imaginaryimpedance/RLC_meter/PCB/rlc_meter.kicad_pcb

## KiCad design PCB/rlc_meter.kicad_pcb (2023-05-07)

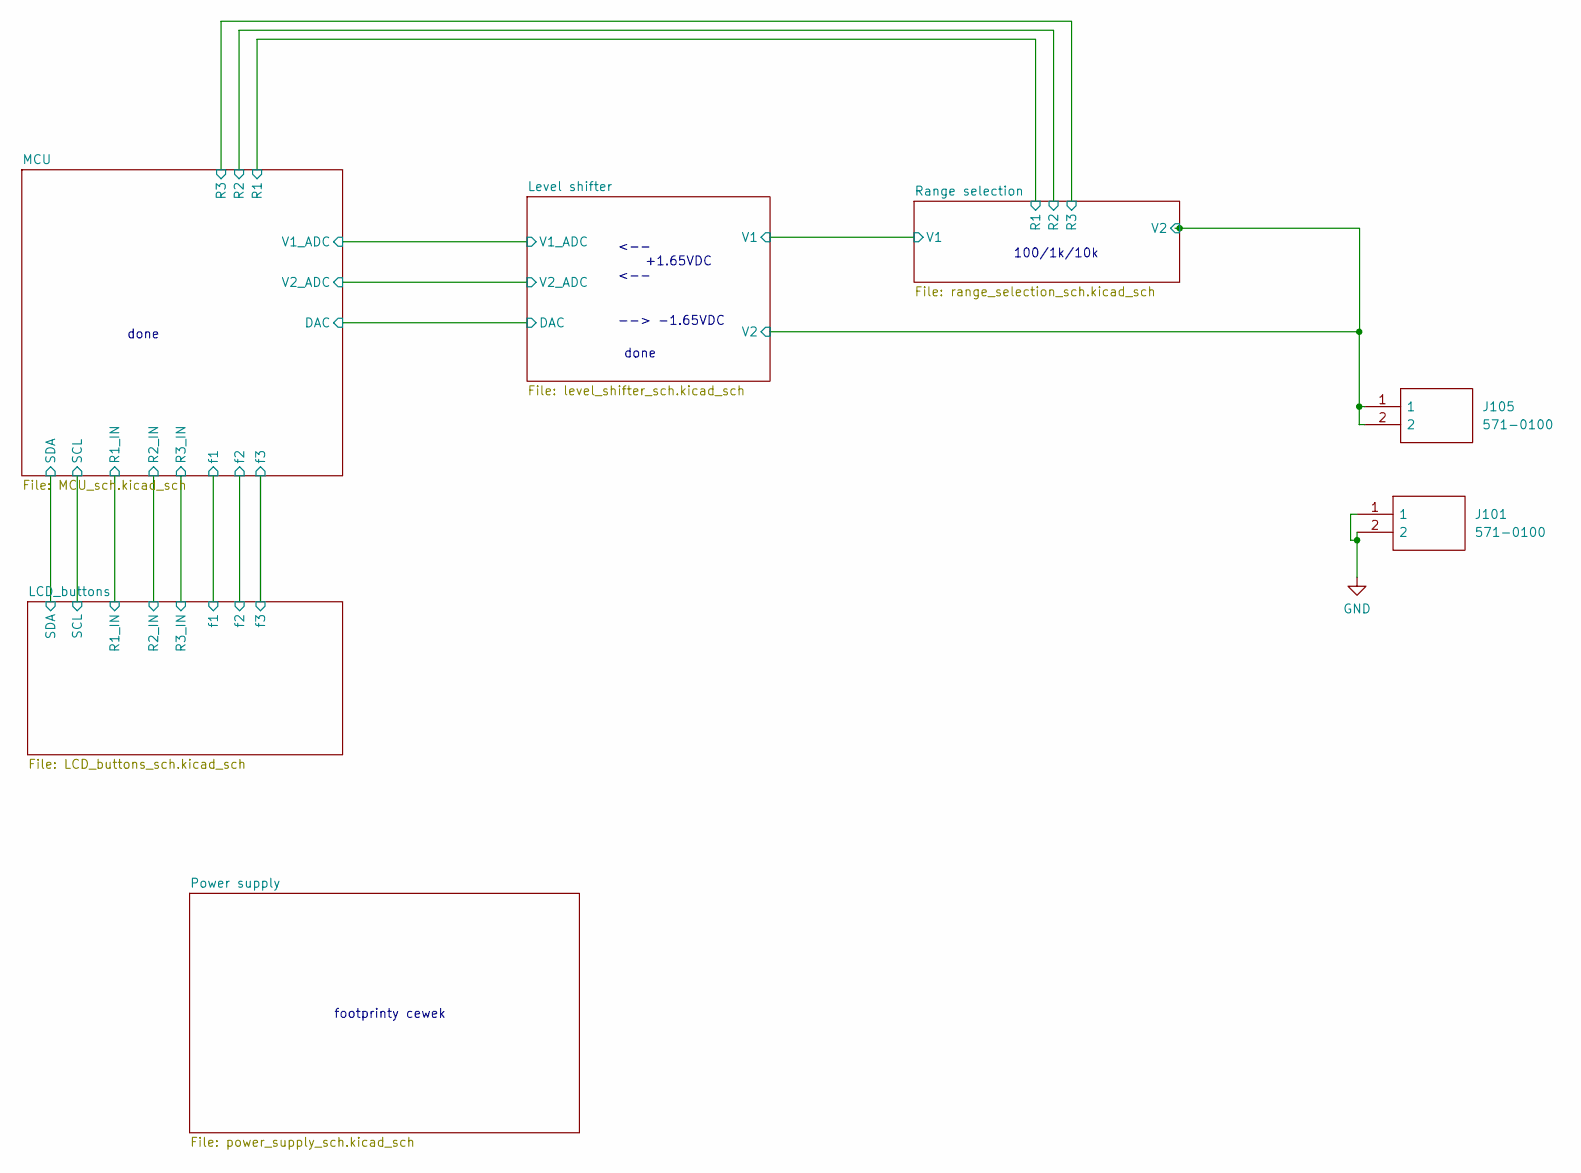
[picture p2: schematic rlc_meter.kicad_sch]

Parts:
J101, J105: 571-0100; 5710100; Manufacturer_Part_Number 571-0100; Mouser Part Number 164-6218

Connections:
/Level shifter/V2: J105.1, J105.2; also elsewhere on the board
GND: J101.1, J101.2; also elsewhere on the board

Notes on the sheet:
100/1k/10k
<-- +1.65VDC <--
footprinty cewek
done
--> -1.65VDC

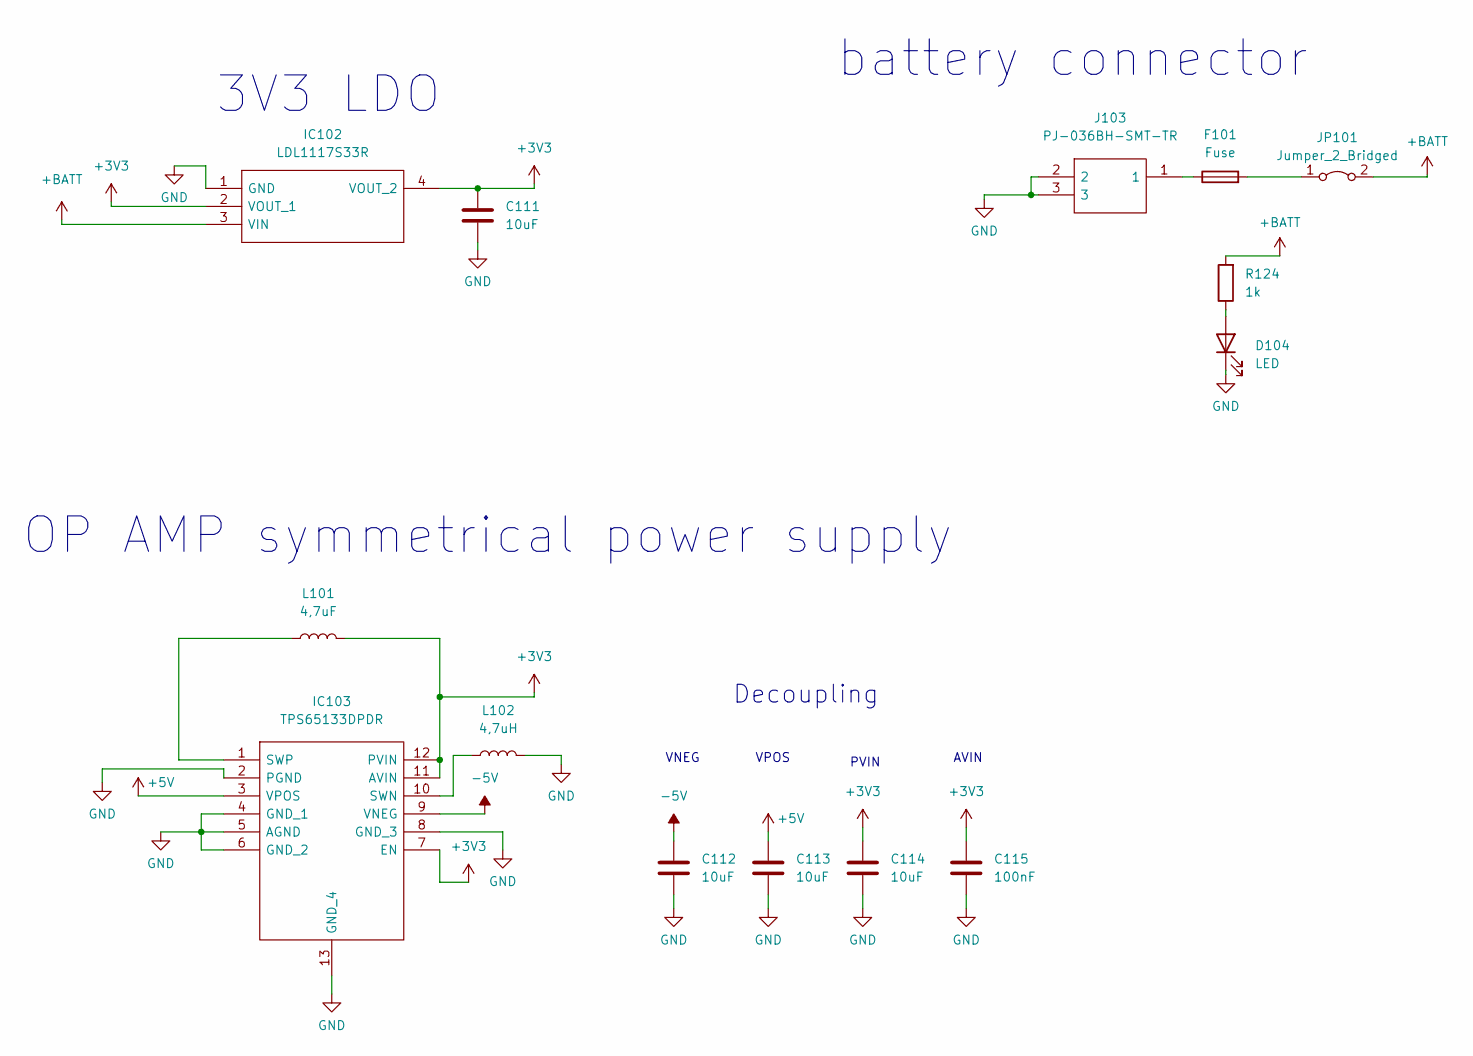
[picture p3: schematic power_supply_sch.kicad_sch]

Parts:
C111, C112, C113, C114: 10uF; C_1206_3216Metric
C115: 100nF; C_1206_3216Metric
D104: LED; LED_1206_3216Metric
F101: Fuse; Fuse_1206_3216Metric
IC102: LDL1117S33R; SOT230P700X180-4N; Manufacturer_Part_Number LDL1117S33R; Mouser Part Number 511-LDL1117S33R
IC103: TPS65133DPDR; SON45P300X300X80-13N-D; Manufacturer_Part_Number TPS65133DPDR; Mouser Part Number 595-TPS65133DPDR
J103: PJ-036BH-SMT-TR; PJ036BHSMTTR; Manufacturer_Part_Number PJ-036BH-SMT-TR; Mouser Part Number 490-PJ-036BH-SMT-TR
JP101: Jumper_2_Bridged; PinHeader_1x02_P2.54mm_Vertical_SMD_Pin1Right
L101: 4,7uF; 744031004
L102: 4,7uH; 744031004
R124: 1k; R_1206_3216Metric

Connections:
+3V3: C111.1, C114.1, C115.1, IC102.2 (VOUT_1), IC102.4 (VOUT_2), IC103.7 (EN), IC103.11 (AVIN), IC103.12 (PVIN), L101.2; also elsewhere on the board
+5V: C113.1, IC103.3 (VPOS); also elsewhere on the board
+BATT: IC102.3 (VIN), JP101.2 (B), R124.2
-5V: C112.1, IC103.9 (VNEG); also elsewhere on the board
GND: C111.2, C112.2, C113.2, C114.2, C115.2, D104.1 (K), IC102.1 (GND), IC103.2 (PGND), IC103.4 (GND_1), IC103.5 (AGND), IC103.6 (GND_2), IC103.8 (GND_3), IC103.13 (GND_4), J103.2, J103.3, L102.2; also elsewhere on the board
unnamed: D104.2 (A), R124.1
unnamed: F101.1, J103.1
unnamed: F101.2, JP101.1 (A)
unnamed: IC103.1 (SWP), L101.1
unnamed: IC103.10 (SWN), L102.1

Notes on the sheet:
battery connector
3V3 LDO
VPOS
PVIN
OP AMP symmetrical power supply
AVIN
Decoupling
VNEG

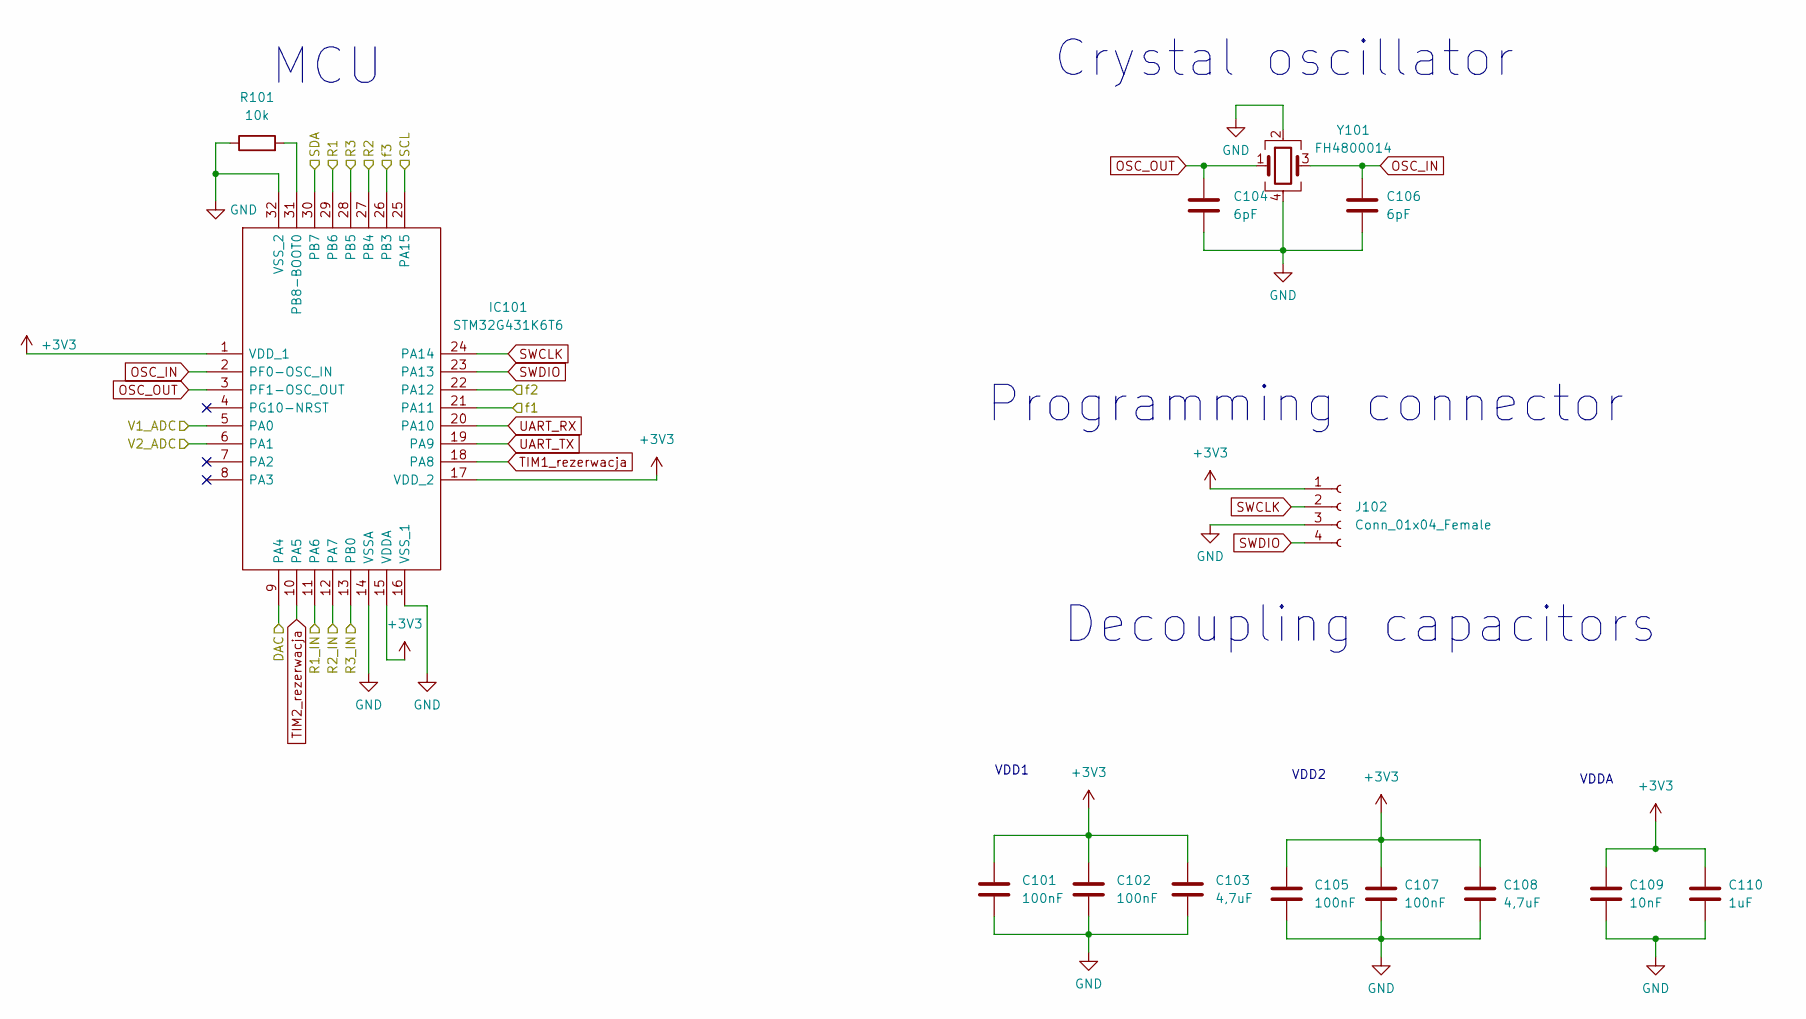
[picture p4: schematic MCU_sch.kicad_sch]

Parts:
C101, C102, C105, C107: 100nF; C_1206_3216Metric
C103, C108: 4,7uF; C_1206_3216Metric
C104, C106: 6pF; C_1206_3216Metric
C109: 10nF; C_1206_3216Metric
C110: 1uF; C_1206_3216Metric
IC101: STM32G431K6T6; QFP80P900X900X160-32N; Manufacturer_Part_Number STM32G431K6T6; Mouser Part Number 511-STM32G431K6T6
J102: Conn_01x04_Female; PinHeader_1x04_P2.54mm_Vertical_SMD_Pin1Left
R101: 10k; R_1206_3216Metric
Y101: FH4800014

Connections:
+3V3: C101.1, C102.1, C103.1, C105.1, C107.1, C108.1, C109.1, C110.1, IC101.1 (VDD_1), IC101.15 (VDDA), IC101.17 (VDD_2), J102.1; also elsewhere on the board
/LCD_buttons/R1_IN: IC101.11 (PA6); also elsewhere on the board
/LCD_buttons/R2_IN: IC101.12 (PA7); also elsewhere on the board
/LCD_buttons/R3_IN: IC101.13 (PB0); also elsewhere on the board
/LCD_buttons/SCL: IC101.25 (PA15); also elsewhere on the board
/LCD_buttons/SDA: IC101.30 (PB7); also elsewhere on the board
/LCD_buttons/f1: IC101.21 (PA11); also elsewhere on the board
/LCD_buttons/f2: IC101.22 (PA12); also elsewhere on the board
/LCD_buttons/f3: IC101.26 (PB3); also elsewhere on the board
/Level shifter/DAC: IC101.9 (PA4); also elsewhere on the board
/Level shifter/V1_ADC: IC101.5 (PA0); also elsewhere on the board
/Level shifter/V2_ADC: IC101.6 (PA1); also elsewhere on the board
/MCU/R1: IC101.29 (PB6); also elsewhere on the board
/MCU/R2: IC101.27 (PB4); also elsewhere on the board
/MCU/R3: IC101.28 (PB5); also elsewhere on the board
GND: C101.2, C102.2, C103.2, C104.2, C105.2, C106.2, C107.2, C108.2, C109.2, C110.2, IC101.14 (VSSA), IC101.16 (VSS_1), IC101.32 (VSS_2), J102.3, R101.1, Y101.2, Y101.4; also elsewhere on the board
unnamed: IC101.31 (PB8-BOOT0), R101.2
OSC_IN: C106.1, IC101.2 (PF0-OSC_IN), Y101.3
OSC_OUT: C104.1, IC101.3 (PF1-OSC_OUT), Y101.1
SWCLK: IC101.24 (PA14), J102.2
SWDIO: IC101.23 (PA13), J102.4
TIM1_rezerwacja: IC101.18 (PA8)
TIM2_rezerwacja: IC101.10 (PA5)
UART_RX: IC101.20 (PA10)
UART_TX: IC101.19 (PA9)

Notes on the sheet:
VDD2
MCU
VDD1
VDDA
Decoupling capacitors
Crystal oscillator
Programming connector

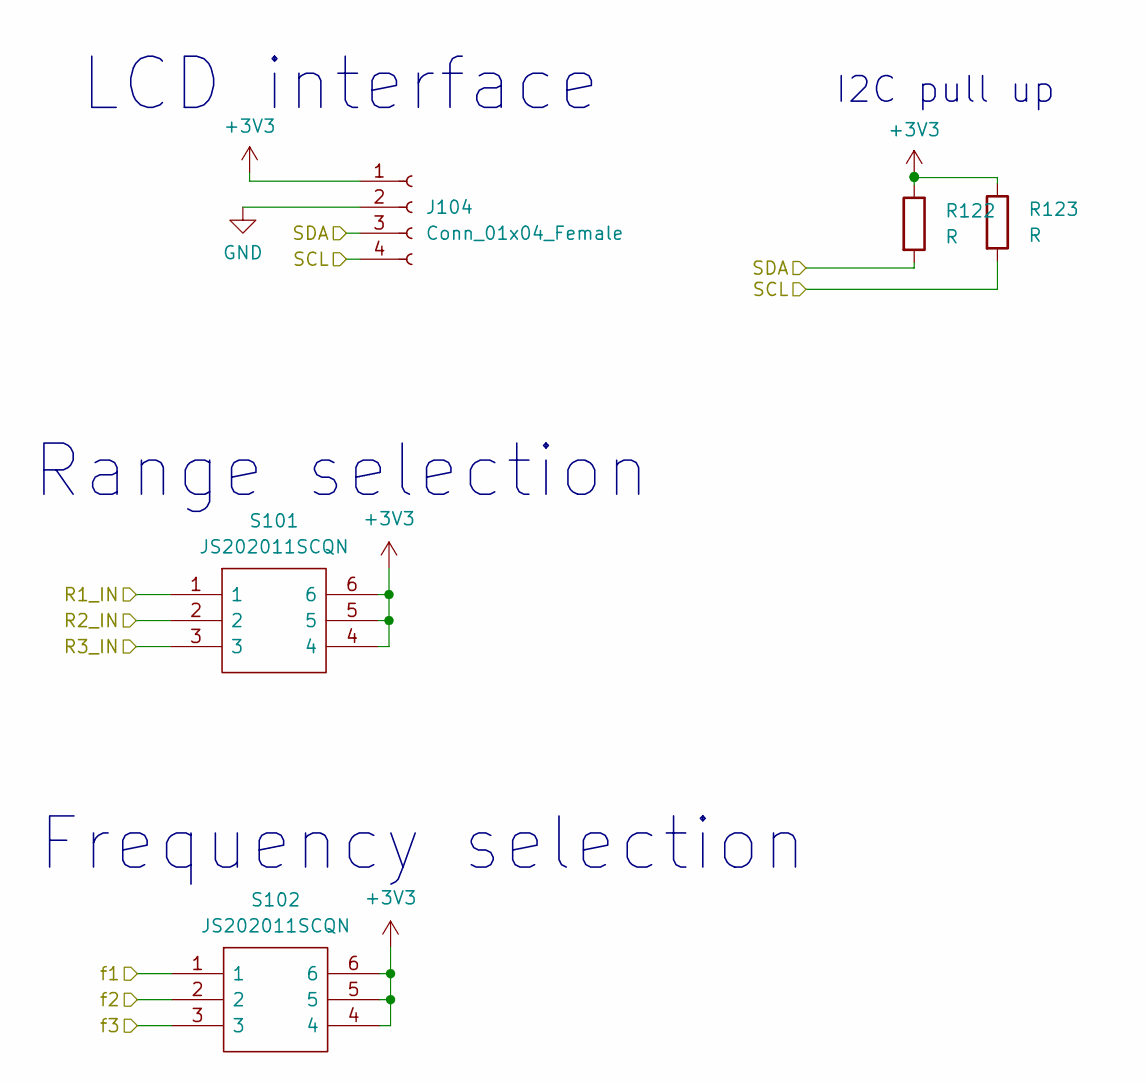
[picture p5: schematic LCD_buttons_sch.kicad_sch]

Parts:
J104: Conn_01x04_Female; PinHeader_1x04_P2.54mm_Vertical_SMD_Pin1Left
R122, R123: R; R_1206_3216Metric
S101, S102: JS202011SCQN; Manufacturer_Part_Number JS202011SCQN; Mouser Part Number 611-JS202011SCQN

Connections:
+3V3: J104.1, R122.1, R123.1, S101.4, S101.5, S101.6, S102.4, S102.5, S102.6; also elsewhere on the board
/LCD_buttons/R1_IN: S101.1; also elsewhere on the board
/LCD_buttons/R2_IN: S101.2; also elsewhere on the board
/LCD_buttons/R3_IN: S101.3; also elsewhere on the board
/LCD_buttons/SCL: J104.4, R123.2; also elsewhere on the board
/LCD_buttons/SDA: J104.3, R122.2; also elsewhere on the board
/LCD_buttons/f1: S102.1; also elsewhere on the board
/LCD_buttons/f2: S102.2; also elsewhere on the board
/LCD_buttons/f3: S102.3; also elsewhere on the board
GND: J104.2; also elsewhere on the board

Notes on the sheet:
I2C pull up
LCD interface
Frequency selection
Range selection

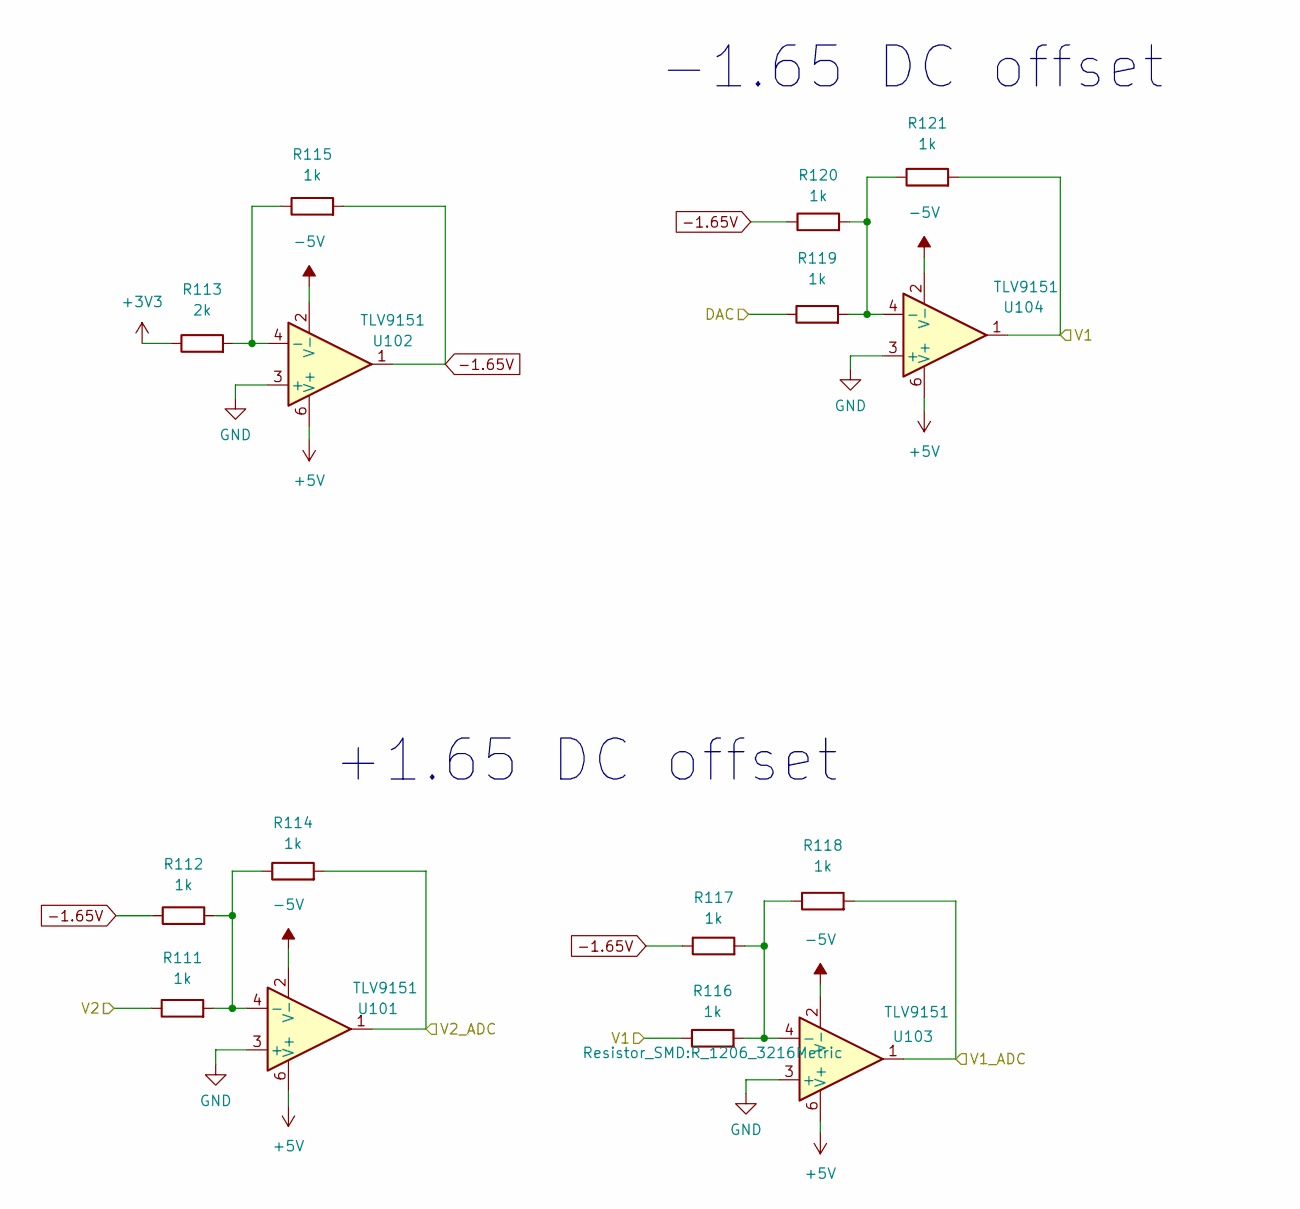
[picture p6: schematic level_shifter_sch.kicad_sch]

Parts:
R111, R112, R114, R115, R116, R117, R118, R119, R120, R121: 1k; R_1206_3216Metric
R113: 2k; R_1206_3216Metric
U101, U102, U103, U104: TLV9151; SOT95P280X145-6N

Connections:
+3V3: R113.1; also elsewhere on the board
+5V: U101.6 (V+), U102.6 (V+), U103.6 (V+), U104.6 (V+); also elsewhere on the board
-1.65V: R112.1, R115.2, R117.1, R120.1, U102.1
-5V: U101.2 (V-), U102.2 (V-), U103.2 (V-), U104.2 (V-); also elsewhere on the board
/Level shifter/DAC: R119.1; also elsewhere on the board
/Level shifter/V1: R116.1, R121.2, U104.1; also elsewhere on the board
/Level shifter/V1_ADC: R118.2, U103.1; also elsewhere on the board
/Level shifter/V2: R111.1; also elsewhere on the board
/Level shifter/V2_ADC: R114.2, U101.1; also elsewhere on the board
GND: U101.3 (+), U102.3 (+), U103.3 (+), U104.3 (+); also elsewhere on the board
unnamed: R111.2, R112.2, R114.1, U101.4 (-)
unnamed: R113.2, R115.1, U102.4 (-)
unnamed: R116.2, R117.2, R118.1, U103.4 (-)
unnamed: R119.2, R120.2, R121.1, U104.4 (-)

Notes on the sheet:
-1.65 DC offset
+1.65 DC offset

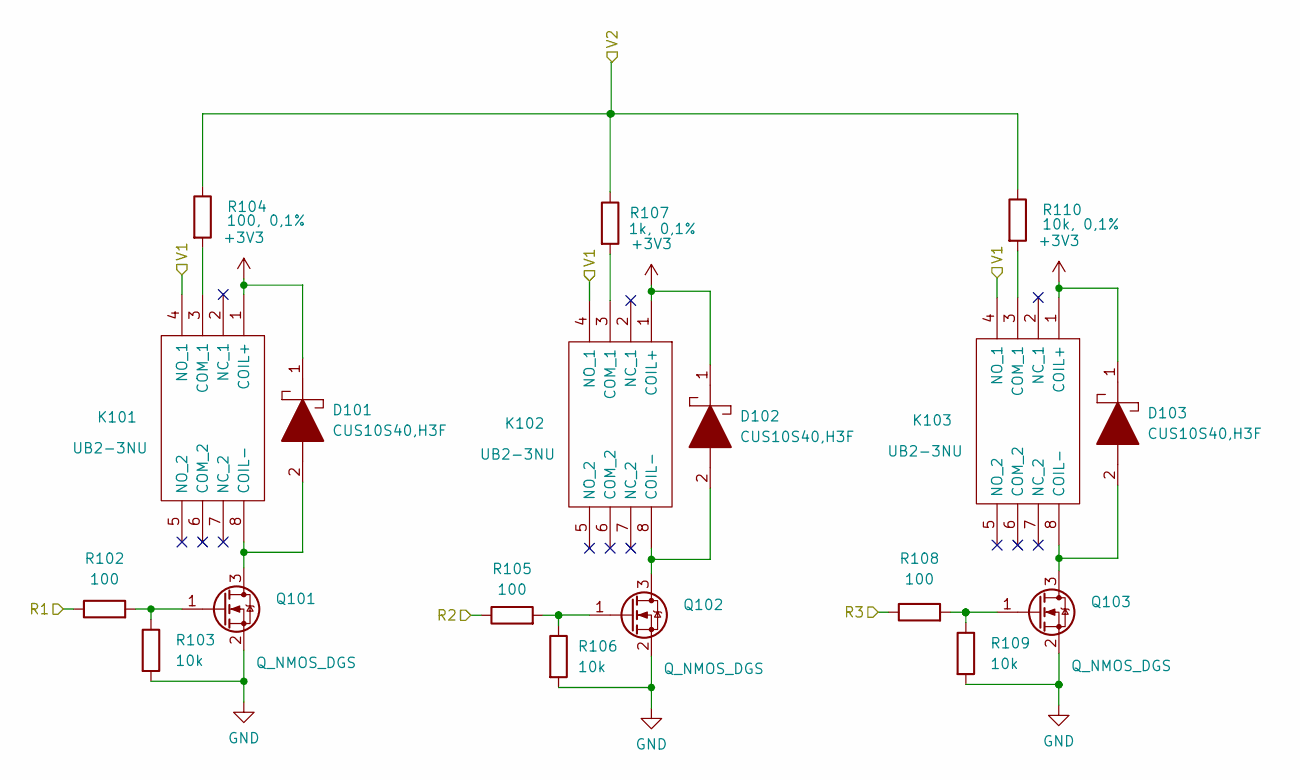
[picture p7: schematic range_selection_sch.kicad_sch]

Parts:
D101, D102, D103: CUS10S40,H3F; CUS10S40H3F; Manufacturer_Part_Number CUS10S40,H3F; Mouser Part Number 757-CUS10S40H3F
K101, K102, K103: UB2-3NU; UB23NU; Manufacturer_Part_Number UB2-3NU; Mouser Part Number 551-UB2-3NU
Q101, Q102, Q103: Q_NMOS_DGS; SOT96P237X111-3N
R102, R105, R108: 100; R_1206_3216Metric
R103, R106, R109: 10k; R_1206_3216Metric
R104: 100, 0,1%; R_1206_3216Metric
R107: 1k, 0,1%; R_1206_3216Metric
R110: 10k, 0,1%; R_1206_3216Metric

Connections:
+3V3: D101.1, D102.1, D103.1, K101.1 (COIL+), K102.1 (COIL+), K103.1 (COIL+); also elsewhere on the board
/Level shifter/V1: K101.4 (NO_1), K102.4 (NO_1), K103.4 (NO_1); also elsewhere on the board
/Level shifter/V2: R104.1, R107.1, R110.1; also elsewhere on the board
/MCU/R1: R102.1; also elsewhere on the board
/MCU/R2: R105.1; also elsewhere on the board
/MCU/R3: R108.1; also elsewhere on the board
GND: Q101.2 (S), Q102.2 (S), R103.2, R106.2, R109.2; also elsewhere on the board
unnamed: D101.2, K101.8 (COIL-), Q101.3 (D)
unnamed: D102.2, K102.8 (COIL-), Q102.3 (D)
unnamed: D103.2, K103.8 (COIL-), Q103.3 (D)
unnamed: K101.3 (COM_1), R104.2
unnamed: K102.3 (COM_1), R107.2
unnamed: K103.3 (COM_1), R110.2
unnamed: Q101.1 (G), R102.2, R103.1
unnamed: Q102.1 (G), R105.2, R106.1
unnamed: Q103.1 (G), R108.2, R109.1

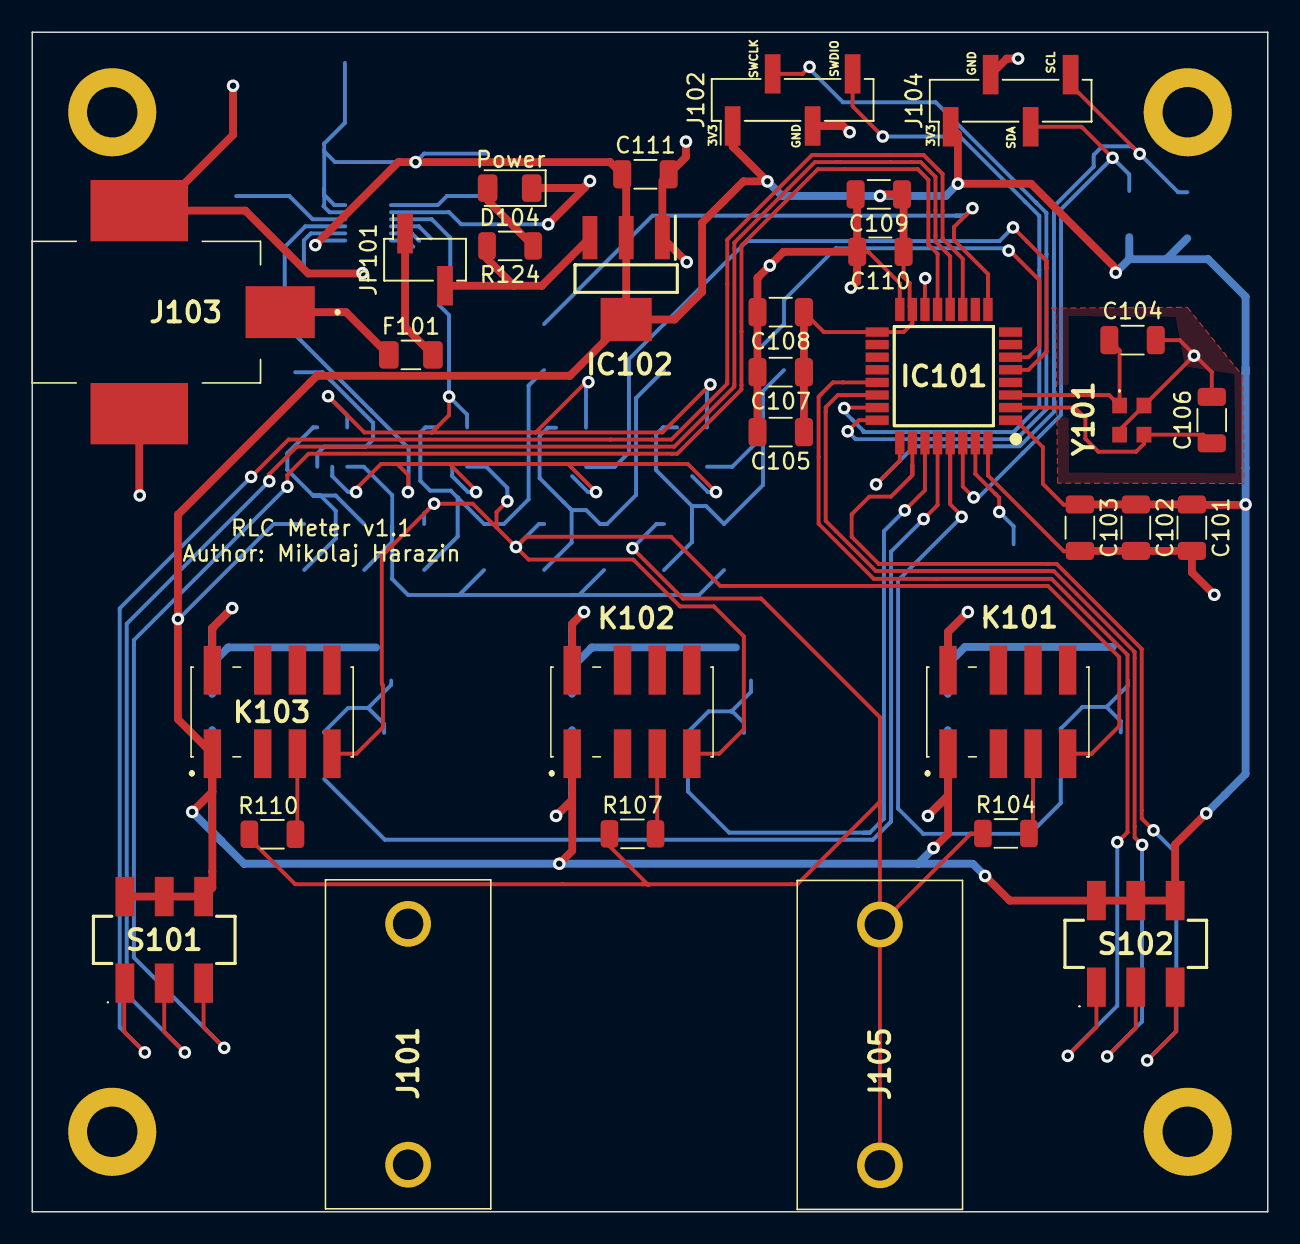
[picture p8: board rlc_meter.kicad_pcb from above]

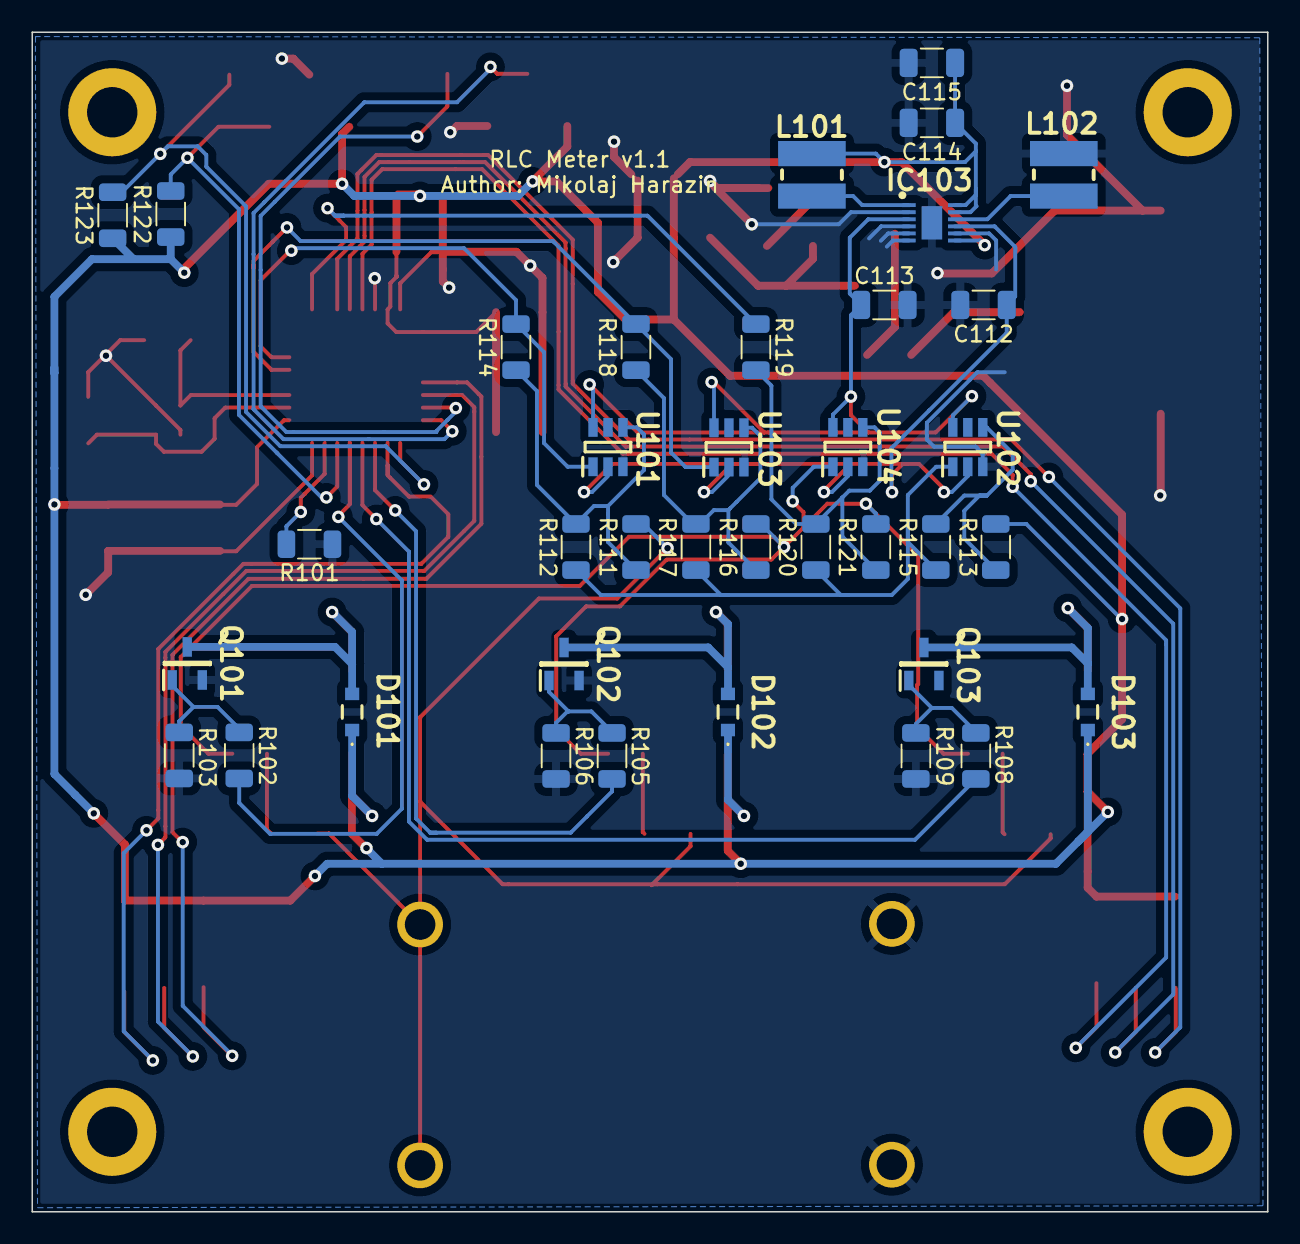
[picture p9: board rlc_meter.kicad_pcb from below]

Board: 2 copper layers, 78.5 x 74.9 mm, 68 parts (37 on the bottom side), 45 nets.
