imaginaryimpedance/RLC_meter/Code/RLC_G4/Core/Src/main.c

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
/* Includes ------------------------------------------------------------------*/
#include "main.h"

/* USER CODE BEGIN Includes */
#include "fonts.h"  //oled
#include "ssd1306.h" //oled
#include "test.h"  //oled
#include "math.h"

/* USER CODE END Includes */

/* USER CODE BEGIN PD */

//DAC sine wave sample points

#define NS  128

uint32_t Wave_LUT[NS] = {
    2048, 2149, 2250, 2350, 2450, 2549, 2646, 2742, 2837, 2929, 3020, 3108, 3193, 3275, 3355,
    3431, 3504, 3574, 3639, 3701, 3759, 3812, 3861, 3906, 3946, 3982, 4013, 4039, 4060, 4076,
    4087, 4094, 4095, 4091, 4082, 4069, 4050, 4026, 3998, 3965, 3927, 3884, 3837, 3786, 3730,
    3671, 3607, 3539, 3468, 3394, 3316, 3235, 3151, 3064, 2975, 2883, 2790, 2695, 2598, 2500,
    2400, 2300, 2199, 2098, 1997, 1896, 1795, 1695, 1595, 1497, 1400, 1305, 1212, 1120, 1031,
    944, 860, 779, 701, 627, 556, 488, 424, 365, 309, 258, 211, 168, 130, 97,
    69, 45, 26, 13, 4, 0, 1, 8, 19, 35, 56, 82, 113, 149, 189,
    234, 283, 336, 394, 456, 521, 591, 664, 740, 820, 902, 987, 1075, 1166, 1258,
    1353, 1449, 1546, 1645, 1745, 1845, 1946, 2047
};

/* USER CODE END PD */

ADC_HandleTypeDef hadc1;
ADC_HandleTypeDef hadc2;

DAC_HandleTypeDef hdac1;
DMA_HandleTypeDef hdma_dac1_ch2;

I2C_HandleTypeDef hi2c1;

TIM_HandleTypeDef htim2;
TIM_HandleTypeDef htim3;
TIM_HandleTypeDef htim4;

/* USER CODE BEGIN PV */
int fSine = 50; //DAC sine frequency
int Rn = 100;  //shunt resistance

int R = 27;   //measured resistance
int X = 0;   //measured reactance

int V1 = 0; //measured voltage1
int V2 = 0; //measured voltage2

uint32_t V1_avg=0;  //DC offset

uint32_t V1_sum=0;
uint32_t V2_sum=0;

float V1_rms=0;			//calculated voltage1 rms
float V2_rms =0;  		//calculated voltage2 rms

uint32_t samples = 0; //sample count

int flag = 0; //flag = 1 for TIM3 interrupt

uint32_t V1_t,V2_t;

/* USER CODE END PV */

void SystemClock_Config(void);
static void MX_GPIO_Init(void);
static void MX_DMA_Init(void);
static void MX_I2C1_Init(void);
static void MX_DAC1_Init(void);
static void MX_TIM2_Init(void);
static void MX_ADC1_Init(void);
static void MX_TIM3_Init(void);
static void MX_ADC2_Init(void);
static void MX_TIM4_Init(void);
/**
  * @brief  The application entry point.
  * @retval int
  */
int main(void)
{
  /* MCU Configuration--------------------------------------------------------*/

  /* Reset of all peripherals, Initializes the Flash interface and the Systick. */
  HAL_Init();

  /* Configure the system clock */
  SystemClock_Config();

  /* Initialize all configured peripherals */
  MX_GPIO_Init();
  MX_DMA_Init();
  MX_I2C1_Init();
  MX_DAC1_Init();
  MX_TIM2_Init();
  MX_ADC1_Init();
  MX_TIM3_Init();
  MX_ADC2_Init();
  MX_TIM4_Init();
  /* USER CODE BEGIN 2 */

  //starting timers
  HAL_TIM_Base_Start(&htim2);
  HAL_TIM_Base_Start_IT(&htim3);
  HAL_TIM_Base_Start(&htim4);

  //starting adc
  HAL_ADC_Start(&hadc1);
  HAL_ADC_Start(&hadc2);

  //starting dac dma sine wave generation
  HAL_DAC_Start_DMA(&hdac1, DAC_CHANNEL_2, (uint32_t*)Wave_LUT, 128, DAC_ALIGN_12B_R);

  //oled initialization
  SSD1306_Init();

  //adc calibration
  HAL_ADCEx_Calibration_Start(&hadc1, ADC_SINGLE_ENDED);
  HAL_ADCEx_Calibration_Start(&hadc2, ADC_SINGLE_ENDED);




  int oled(void)
  {

	 //defining buffers
	 char R_buffer[10];
	 sprintf(R_buffer,"%d",R);
	 char X_buffer[10];
	 sprintf(X_buffer,"%d",X);


	 //converting to char and sending to oled
	 SSD1306_Clear ();
	 SSD1306_GotoXY (0,0);
	 SSD1306_Puts ("|Z|=", &Font_11x18, 1);
	 SSD1306_GotoXY (50,0);
	 SSD1306_Puts (R_buffer, &Font_11x18, 1);
	 SSD1306_GotoXY (0,20);
	 SSD1306_Puts ("V1=", &Font_11x18, 1);
	 SSD1306_GotoXY (30,20);
	 SSD1306_Puts (X_buffer, &Font_11x18, 1);

	 //writing shunt resistance and sine frequency

	 //sine wave
	 SSD1306_GotoXY (0,40);

	 if(fSine == 5000){
	 SSD1306_Puts ("5kHz", &Font_11x18, 1);
	 }
	 else if(fSine == 1000){
		 SSD1306_Puts ("1kHz", &Font_11x18, 1);
	 }
	 else if (fSine == 50){
		 SSD1306_Puts ("50Hz", &Font_11x18, 1);
	 }

	 //shunt resistance
	 SSD1306_GotoXY (50,40);

	 if(Rn == 10000){
	 SSD1306_Puts ("10kOhm", &Font_11x18, 1);
	 }
	 else if(Rn==1000){
		 SSD1306_Puts ("1kOhm", &Font_11x18, 1);
	 }
	 else if(Rn==100){
	 		 SSD1306_Puts ("100Ohm", &Font_11x18, 1);
	 	 }

	 //displaying new data
	 SSD1306_UpdateScreen();

  }

  int rangeSelection(void)
  {
	  //selecting sine frequency

	  //50Hz
	  if(HAL_GPIO_ReadPin(GPIOA, GPIO_PIN_11)== GPIO_PIN_SET){

		  __HAL_TIM_SET_AUTORELOAD(&htim2,1499);	//DAC timers frequency
		  __HAL_TIM_SET_AUTORELOAD(&htim3,47999);	//tim3 frequency for adc conversion = 1kHz

		  fSine = 50;
	  }
	  //5kHz
	  else if(HAL_GPIO_ReadPin(GPIOB, GPIO_PIN_3)== GPIO_PIN_SET){

		 __HAL_TIM_SET_AUTORELOAD(&htim2, 14); 		//DAC timers frequency
		 __HAL_TIM_SET_AUTORELOAD(&htim3,319); 		//tim3 frequency for adc conversion = 150kHz

		  fSine = 5000;
	  }
	  //1kHz
	  else{

		 __HAL_TIM_SET_AUTORELOAD(&htim2,74); 		//DAC timers frequency
		 __HAL_TIM_SET_AUTORELOAD(&htim3,2399);		//tim3 frequency for adc conversion = 20kHz

		  fSine = 1000;
	  }

	  //selecting shunt resistance

	  //100 Ohm
	  if(HAL_GPIO_ReadPin(GPIOA, GPIO_PIN_6)== GPIO_PIN_SET){
		  Rn = 100;
		  HAL_GPIO_WritePin(GPIOB, GPIO_PIN_5 ,GPIO_PIN_RESET);
		  HAL_GPIO_WritePin(GPIOB, GPIO_PIN_4 ,GPIO_PIN_RESET);
		  HAL_GPIO_WritePin(GPIOB, GPIO_PIN_6 ,GPIO_PIN_SET);
	  	  }

	  //10kOhm
	  else if(HAL_GPIO_ReadPin(GPIOB, GPIO_PIN_0)== GPIO_PIN_SET){
		  Rn = 10000;
		  HAL_GPIO_WritePin(GPIOB, GPIO_PIN_5 ,GPIO_PIN_RESET);
		  HAL_GPIO_WritePin(GPIOB, GPIO_PIN_6 ,GPIO_PIN_RESET);
		  HAL_GPIO_WritePin(GPIOB, GPIO_PIN_4 ,GPIO_PIN_SET);
	  	  }

	  //1kohm
	  else{
		  Rn = 1000;
		  HAL_GPIO_WritePin(GPIOB, GPIO_PIN_6 ,GPIO_PIN_RESET);
		  HAL_GPIO_WritePin(GPIOB, GPIO_PIN_4 ,GPIO_PIN_RESET);
		  HAL_GPIO_WritePin(GPIOB, GPIO_PIN_5 ,GPIO_PIN_SET);
	  	  }
  }

  int getDCOffset(void){

	  while(samples<(1000)){

	 	if(flag == 1){  							 //flag =1 -> TIM3 interrupt

	 		V1 = HAL_ADC_GetValue(&hadc1); 			 //ADC1 Read

	 		V1_sum = V1_sum+V1;
	 		samples = samples+1;

	 		HAL_ADC_Start(&hadc1);					//starting another adc conversion

	 		flag = 0;								//reseting flag
	 		  }
	 	  }

	 	  V1_avg = V1_sum/samples;					//Calculating DC Offset based on V1
	 	  samples = 0;
	 	  V1_sum = 0;

  }

  int getRMSValue(void){

	  while(samples<(1000)){
		  if(flag == 1){ 							//flag =1 -> TIM3 interrupt

		  	V2 = HAL_ADC_GetValue(&hadc2)-V1_avg;	//ADC2 Read
		  	V1 = HAL_ADC_GetValue(&hadc1)-V1_avg;	//ADC1 Read

		  	V1_sum = V1_sum+V1*V1; 					//summing squares
		  	V2_sum = V2_sum+V2*V2;
		  	samples = samples+1;

		  	HAL_ADC_Start(&hadc2);					//starting another adc conversion
		  	HAL_ADC_Start(&hadc1);

		  	flag =0;								//reseting flag
		  	  }
		  }

		  V1_rms = sqrtf(V1_sum/samples);			//calculating rms values
		  V2_rms = sqrtf(V2_sum/samples);

		  V1_sum = 0;
		  V2_sum = 0;
		  samples = 0;
  }

 int getPhase(void){

	 while(samples<(1000)){
	 		  if(flag == 1){ 							//flag =1 -> TIM3 interrupt

	 		  	V2 = HAL_ADC_GetValue(&hadc2)-V1_avg;	//ADC2 Read
	 		  	V1 = HAL_ADC_GetValue(&hadc1)-V1_avg;	//ADC1 Read

	 		  	if(V1==0){
	 		  	V1_t=__HAL_TIM_GetCounter(&htim4);
	 		  	}
	 		  	if(V2==0){
	 		  	V2_t=__HAL_TIM_GetCounter(&htim4);
	 		  	}

	 		  	samples = samples+1;

	 		  	HAL_ADC_Start(&hadc2);					//starting another adc conversion
	 		  	HAL_ADC_Start(&hadc1);

	 		  	flag =0;								//reseting flag
	 		  	  }
	 		  }

	 	 	 Phase = V2_t - V1_t;

	 		  samples = 0;


 }
  /* USER CODE END 2 */

  /* Infinite loop */
  /* USER CODE BEGIN WHILE */
  while (1)
  {
	  rangeSelection();

	  getDCOffset();

	  getRMSValue();


	  R =V1_rms;
	  X = V2_rms;

	  oled();

	 HAL_Delay (2000);
    /* USER CODE END WHILE */

    /* USER CODE BEGIN 3 */
  }
  /* USER CODE END 3 */
}

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
/* USER CODE BEGIN 4 */
void HAL_TIM_PeriodElapsedCallback(TIM_HandleTypeDef* htim)
{
	flag =1;

}
/* USER CODE END 4 */
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
