imaginaryimpedance/RLC_meter/Code/RLC_G4/RLC_G4.ioc

Mcu.UserName=STM32G431K6Tx
PA0.Signal=ADC1_IN1
PA1.Signal=ADC2_IN2
PA11.Signal=GPIO_Input
PA12.Signal=GPIO_Input
PA13.Signal=SYS_JTMS-SWDIO
PA14.Signal=SYS_JTCK-SWCLK
PA15.Signal=I2C1_SCL
PA5.Signal=COMP_DAC12_group
PA6.Signal=GPIO_Input
PA7.Signal=GPIO_Input
PB0.Signal=GPIO_Input
PB3.Signal=GPIO_Input
PB4.Signal=GPIO_Output
PB5.Signal=GPIO_Output
PB6.Signal=GPIO_Output
PB7.Signal=I2C1_SDA
PF0-OSC_IN.Signal=RCC_OSC_IN
PF1-OSC_OUT.Signal=RCC_OSC_OUT
