imaginaryimpedance/RLC_meter/(notices)

Notices in the files:
Code/RLC_G4/Core/Src/main.c:
Copyright (c) 2023 STMicroelectronics.
All rights reserved.
This software is licensed under terms that can be found in the LICENSE file
